gentle-breeze-blow/RM_Class-D-amplifier/docs/image2.png

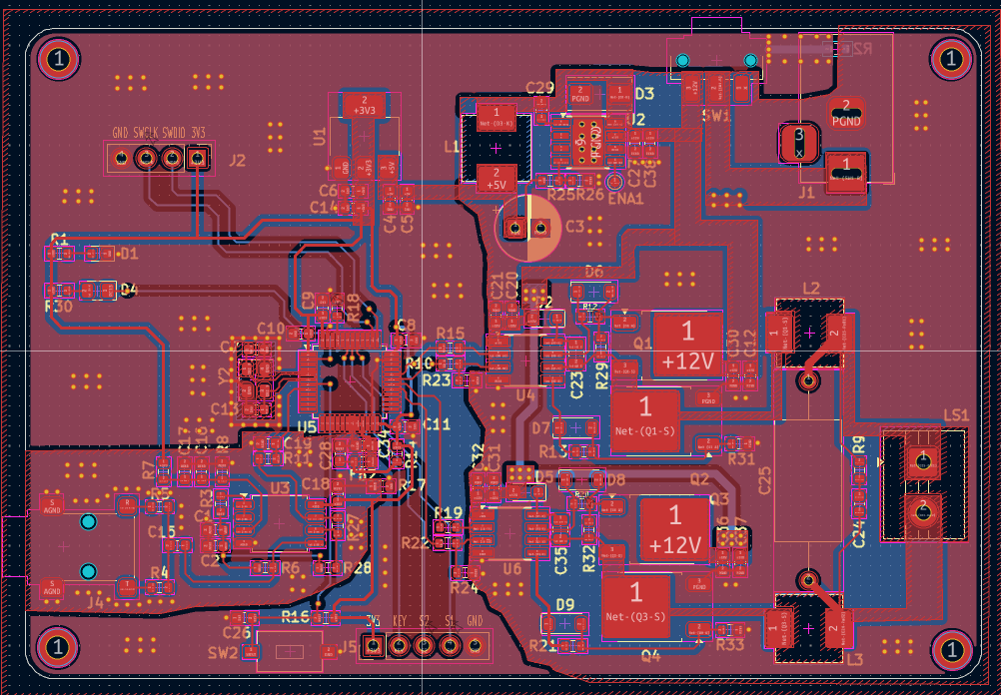
docs/image2.png
