gentle-breeze-blow/RM_Class-D-amplifier/program/user/include/main.h

#define LED_Pin GPIO_PIN_13
#define LED_GPIO_Port GPIOC
#define ADC_in_Pin GPIO_PIN_0
#define ADC_in_GPIO_Port GPIOA
#define SD_B_Pin GPIO_PIN_15
#define SD_B_GPIO_Port GPIOB
#define PWMB_Pin GPIO_PIN_8
#define PWMB_GPIO_Port GPIOA
#define PWMA_Pin GPIO_PIN_9
#define PWMA_GPIO_Port GPIOA
#define SD_A_Pin GPIO_PIN_10
#define SD_A_GPIO_Port GPIOA
#define S1_Pin GPIO_PIN_4
#define S1_GPIO_Port GPIOB
#define S2_Pin GPIO_PIN_5
#define S2_GPIO_Port GPIOB
#define KEY_Pin GPIO_PIN_6
#define KEY_GPIO_Port GPIOB
