gentle-breeze-blow/RM_Class-D-amplifier/(commit log)

2026-04-10 2
    对programme文件进一步处理，剩余gitignore和reademe需要处理
2026-04-12 3
    更改doc文件下图片命名为英文，对应修改readme文件内的图片链接
