gentle-breeze-blow/RM_Class-D-amplifier/(notices)

Notices in the files:
program/user/src/tim.c:
Copyright (c) 2026 STMicroelectronics.
All rights reserved.
This software is licensed under terms that can be found in the LICENSE file
